heigvd-eurobot/hw-wit-cm4/(list of files, drawings)

Other design files:
audio.SchDoc
gpio.SchDoc
i2c-can-lin.SchDoc
PI4.PrjPcb
PI4.SCHLIB
power.SchDoc
title.SchDoc
usb.SchDoc
