heigvd-eurobot/hw-wit-cm4/boot/config.txt

# For more options and information see
# http://rpf.io/configtxt
# Some settings may impact device functionality. See link above for details

# Uncomment some or all of these to enable the optional hardware interfaces
dtparam=i2c_arm=on
dtparam=i2s=on
dtparam=spi=on

[pi4]
# Enable DRM VC4 V3D driver on top of the dispmanx display stack
dtoverlay=vc4-fkms-v3d
max_framebuffers=2

[all]

# Load 64-bit kernel (beta)
kernel=kernel8.img

# Disable Bluetooth for energy save
dtoverlay=disable-bt

# Enable USB
dtoverlay=dwc2,dr_mode=host

# Reduce boot time
disable_splash=1
boot_delay=0
initial_turbo=30

# PWM for RPLidar
dtoverlay=pwm,pin=12,func=4

# Overclocking
# over_voltage=6
# arm_freq=2000

# Configure I2C ports
#dtparam=i2c_vc=on

dtoverlay=i2c0,pins_0_1
#dtoverlay=i2c3,pins_2_3
dtoverlay=i2c1,pins_2_3=1
#dtoverlay=i2c1,pins_44_45=1

# Required to have cameras
start_x=1
gpu_mem=128

# Enable audio (loads snd_bcm2835)
dtparam=audio=on
dtoverlay=i2s-mmap
dtoverlay=googlevoicehat-soundcard
dtparam=i2s=on

# CAN Bus
dtoverlay=mcp2515-can0,oscillator=16000000,interrupt=25

# TPM 2.0 (it causes Kernel Panic)
#dtoverlay=tpm-slb9670

# RTC
dtoverlay=i2c-rtc,ds1307

# RPLidar A3
dtoverlay=uart3

dtoverlay=vc4-fkms-v3d

# More details with `sudo vcdbg log msg`
dtdebug=1
