heigvd-eurobot/hw-wit-cm4/(commit log)

2021-10-15 Add pcbdoc
    [gpio.SchDoc]
2021-11-15 Some updates
    [PI4.PrjPcb, gpio.SchDoc, power.SchDoc]
2021-12-02 Add PcbLibrary
    [PI4.PrjPcb]
2022-03-30 Update setup.md for i2c bus init
    Ajout d'une version avec tee
2022-04-15 Update pi4 PcbLib
2022-04-15 Add Schematic library
    [PI4.SCHLIB]
